scasdi/balancing-cube-main/hardware/cube.kicad_sch

## KiCad design hardware/cube.kicad_sch (2026-10-06)

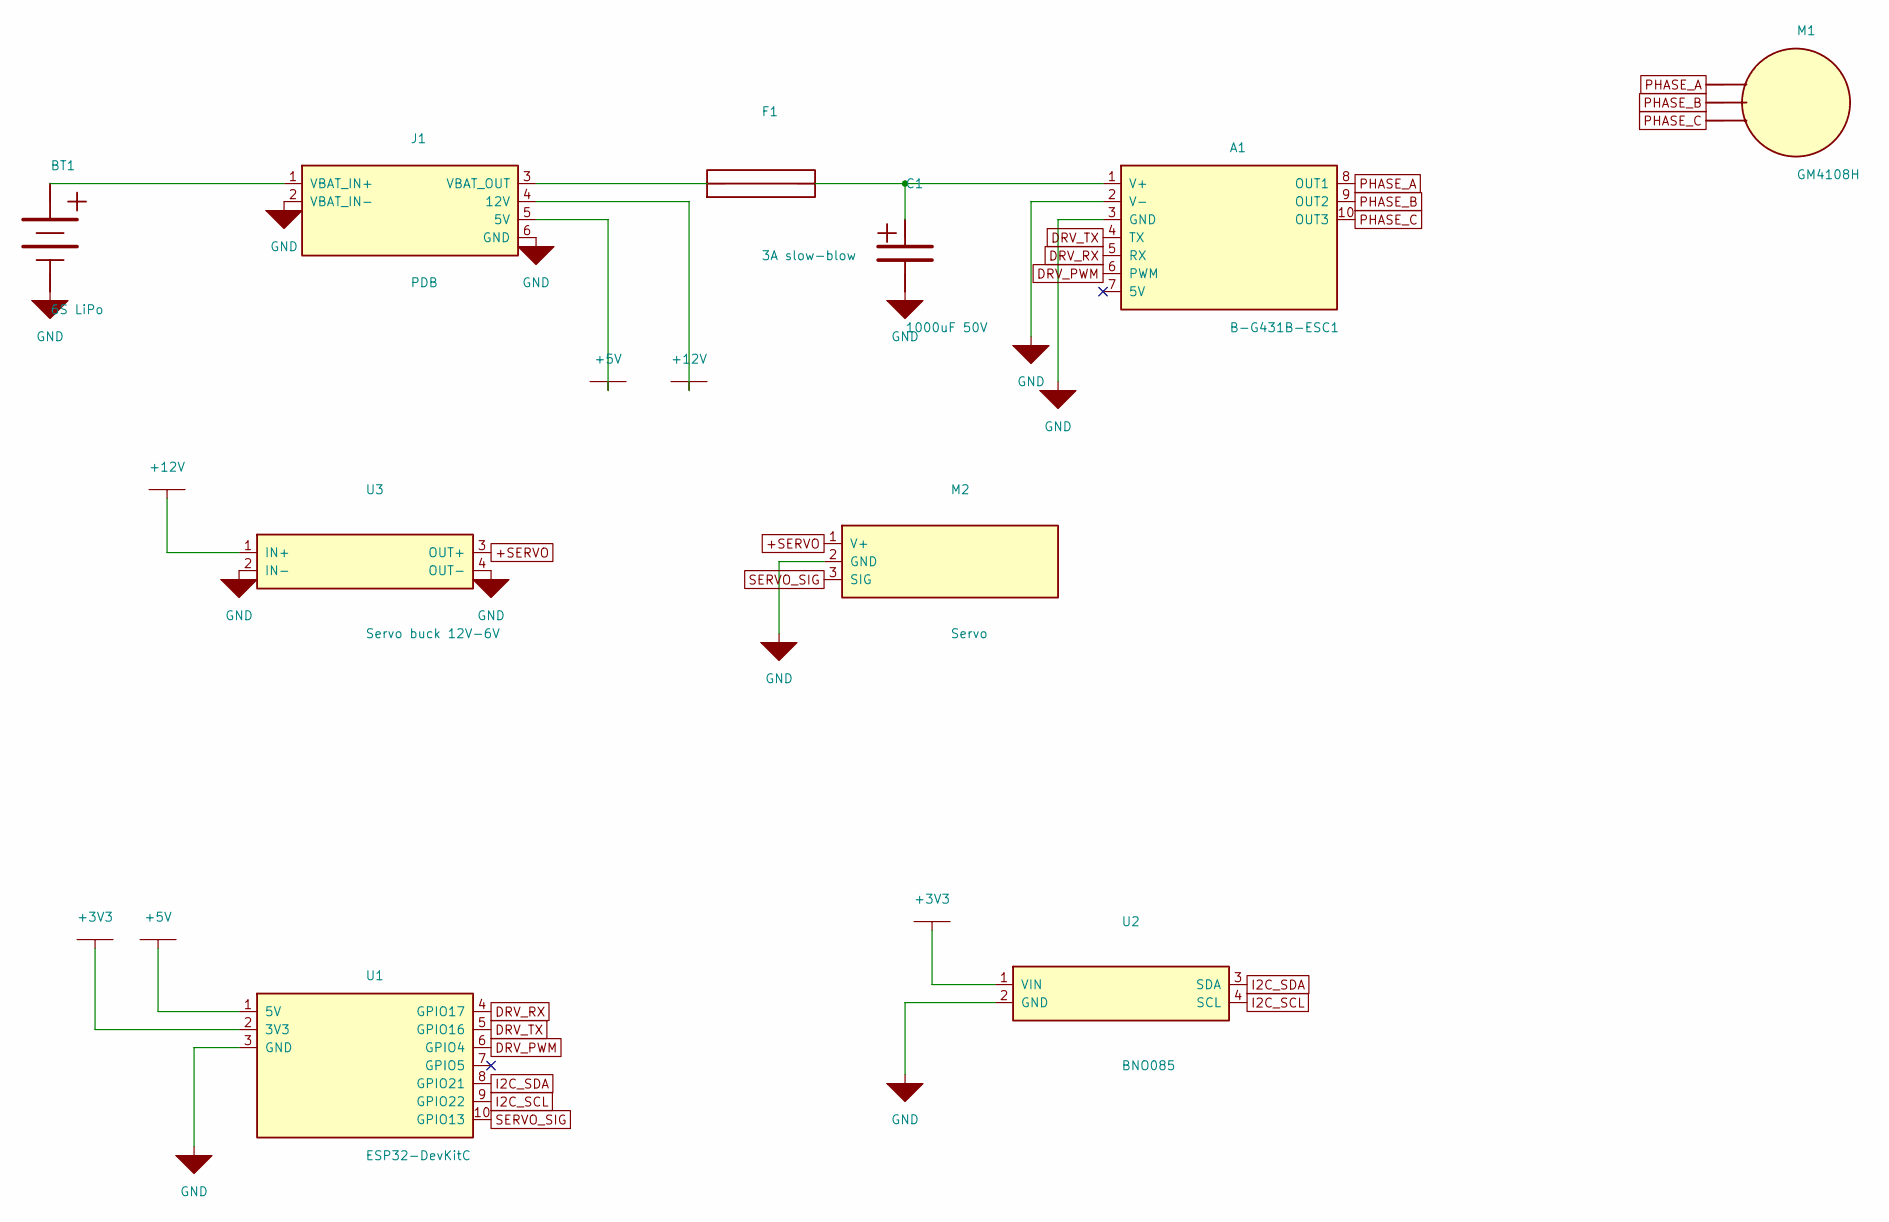
[picture p1: schematic cube.kicad_sch]

Parts:
A1: B-G431B-ESC1
BT1: 6S LiPo
C1: 1000uF 50V
F1: 3A slow-blow
J1: PDB
M1: GM4108H
M2: Servo
U1: ESP32-DevKitC
U2: BNO085
U3: Servo buck 12V-6V

Connections:
+3V3: U1.2 (3V3), U2.1 (VIN)
+5V: J1.5 (5V), U1.1 (5V)
+12V: J1.4 (12V), U3.1 (IN+)
+SERVO: M2.1 (V+), U3.3 (OUT+)
DRV_PWM: A1.6 (PWM), U1.6 (GPIO4)
DRV_RX: A1.5 (RX), U1.4 (GPIO17)
DRV_TX: A1.4 (TX), U1.5 (GPIO16)
GND: A1.2 (V-), A1.3 (GND), BT1.2, C1.2, J1.2 (VBAT_IN-), J1.6 (GND), M2.2 (GND), U1.3 (GND), U2.2 (GND), U3.2 (IN-), U3.4 (OUT-)
I2C_SCL: U1.9 (GPIO22), U2.4 (SCL)
I2C_SDA: U1.8 (GPIO21), U2.3 (SDA)
unnamed: A1.1 (V+), C1.1, F1.2
unnamed: BT1.1, J1.1 (VBAT_IN+)
unnamed: F1.1, J1.3 (VBAT_OUT)
PHASE_A: A1.8 (OUT1), M1.1
PHASE_B: A1.9 (OUT2), M1.2
PHASE_C: A1.10 (OUT3), M1.3
SERVO_SIG: M2.3 (SIG), U1.10 (GPIO13)
