scasdi/balancing-cube-main/src/ESP/commands.cpp

#include "ESP/commands.h"
#include "ESP/comms.h"
#include "ESP/get_params.h"
#include "ESP/state_machine.h"
#include "ESP/LQR.h"
#include "ESP/storage.h"
#include "ESP/pins.h"
#include "components/servo.h"
#include "components/motor_driver.h"
#include <Arduino.h>

static int last_button_state = LOW;
static unsigned long last_debounce_time = 0;
static const unsigned long DEBOUNCE_DELAY_MS = 50;

String process_command(String command) {
    command.trim();

    if (command.startsWith("SET_GAINS:")) {
        String gains_str = command.substring(10);
        int first_comma = gains_str.indexOf(',');
        int second_comma = gains_str.indexOf(',', first_comma + 1);
        
        if (first_comma != -1 && second_comma != -1) {
            float k1 = gains_str.substring(0, first_comma).toFloat();
            float k2 = gains_str.substring(first_comma + 1, second_comma).toFloat();
            float k3 = gains_str.substring(second_comma + 1).toFloat();
            
            lqr_set_gains(k1, k2, k3);
            storage_save_gains(k1, k2, k3);
            return "GAINS_SYNC_OK";
        }
        return "ERROR: INVALID_GAIN_FORMAT";
    }
    else if (command.startsWith("10 ")) {
        float speed_percent = command.substring(3).toFloat();
        command_motor_pwm_speed(speed_percent);
        char buf[32];
        snprintf(buf, sizeof(buf), "SPEED_SET: %.1f%%", speed_percent);
        return String(buf);
    }
    else if (command == "BALANCE") {
        request_state(State::Balance);
        return "BALANCE_MODE_ACTIVATED";
    }
    else if (command == "STOP") {
        request_state(State::Spindown);
        return "SPINNING_DOWN";
    }
    else if (command == "CLEAR_FAULT") {
        request_clear_fault();
        return "FAULT_CLEARED";
    }
    else if (command == "STATUS") {
        // WORST is the longest control cycle since the last reset, and IN names
        // the state it ran in. At or above the 20000 us period means the loop
        // is not keeping its deadline.
        char buf[112];
        snprintf(buf, sizeof(buf), "STATE: %s  FAULT: %s  WORST: %luus IN %s",
                 state_name(get_state()), fault_name(get_fault()),
                 (unsigned long)get_worst_cycle_us(),
                 state_name(get_worst_cycle_state()));
        return String(buf);
    }
    else if (command == "RESET_WORST") {
        request_reset_worst();
        return "WORST_RESET";
    }
    else if (command == "CALIBRATE_ZERO") {
        request_state(State::Calibrate);
        return "STARTING_CALIBRATION";
    }
    else if (command == "GET_PITCH") {
        float pitch_deg = get_shared_pitch_rad() * 180.0f / PI;
        char buf[32];
        snprintf(buf, sizeof(buf), "CURRENT_PITCH: %.2f", pitch_deg);
        return String(buf);
    }

    return "UNKNOWN_CMD: " + command;
}

void commands_init() {
    pinMode(BUTTON, INPUT);
    last_button_state = digitalRead(BUTTON);
}

void commands_update(unsigned long currentMillis) {
    int current_button_state = digitalRead(BUTTON);

    if (current_button_state != last_button_state) {
        last_debounce_time = currentMillis;
    }

    if ((currentMillis - last_debounce_time) > DEBOUNCE_DELAY_MS) {
        static int button_validated_state = LOW;

        if (current_button_state != button_validated_state) {
            button_validated_state = current_button_state;

            if (button_validated_state == HIGH) {
                send_comm_message("BUTTON_PRESSED");
                servo_jump(); 
            }
        }
    }
    last_button_state = current_button_state;

    check_bluetooth_commands();

    if (Serial.available()) {
        String incoming_cmd = Serial.readStringUntil('\n');
        incoming_cmd.trim();
        if (incoming_cmd.length() > 0) {
            if (incoming_cmd == "START_PENDULUM") {
                request_state(State::SysId);
                get_params_start(10000);
            } 
            else if (incoming_cmd == "START_MOTOR_TEST") {
                request_state(State::SysId);
                get_params_start(5000);
            }
            else {
                String reply = process_command(incoming_cmd);
                send_comm_message(reply.c_str());
            }
        }
    }
}
