scasdi/balancing-cube-main/(commit log)

2026-05-23 adding IMU sensor files
2026-05-24 adding imu sensor code, wifi and web server code
2026-05-29 adding commands support and expanding wifi support with button
2026-06-10 adding files for ESP-to-driver and driver-to-motor communication
2026-06-15 servo working
2026-06-21 finalizing param_get flow
2026-06-29 first successful servo jump with extarnel power supply.
2026-07-10 adding driver_ESP comms and bluetooth support
2026-07-15 new versions for driver_motor
2026-07-15 esp to driver update
2026-09-18 Add state machine contract headers (interfaces only, no implementation)
    Proposed interface for the control-side state machine, pending review:
    - states.h State, Event and FaultCode enums. Adds Spindown and a
    latched Fault carrying a reason code, so a trip is
    debuggable after the fact.
    - types.h ControlInput, ControlOutput and Limits. All thresholds
    gathered in one struct; SI units throughout.
    - state_machine.h state_step() as a pure function - no globals, no hardware,
    no clock reads - so the transition table can be exercised
    by host-side unit tests without an ESP32.
    No implementation an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
2026-09-18 Scoped State enum; add Init, Spindown and latched Fault
    State machine naming and structure. No change to the control law or to the
    20 ms loop rate.
    - cube_state -> enum class State : uint8_t. Values were global identifiers;
    IDLE in particular collides readily with Arduino and ESP-IDF macros, and a
    plain enum blocks adding FaultCode, which needs its own None.
    - EDGE_BALANCE -> Balance. The 3D cube balances on a corner; the old name
    baked the 2D prototype into the interface.
    - FALL_TO_IDLE -> Spindown. The old name described a transition, not a state,
    and promised an exit the code never performed.
    - Adds Init, and Fault carrying a FaultCode so a trip is debuggable.
    - init_controller()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
    [commands.cpp, comms.cpp, main.cpp, state_machine.cpp]
2026-10-05 Move STM32 driver sources out of the ESP32 build
    The project could not compile. PlatformIO builds everything under src/, and
    five files each defined setup() and loop():
    src/main.cpp
    src/components/ESP_driver.cpp
    src/components/ESP_to_driver.cpp
    src/components/driver_to_motor_const.cpp
    src/components/driver_to_motor_dyn.cpp
    The last four are firmware for the B-G431B motor driver, not the ESP32. Two
    also use STM32 pin names (PA8, PC10) that do not exist on this target.
    Moved verbatim to firmware/driver/ - contents unchanged, so building them for
    the G431 later works exactly as before. Adds a README there explaining why
    they sit outside src/.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
2026-10-05 Fix comms.cpp build: include the headers it calls into
    comms.cpp calls set_state() and get_params_start() but included neither
    ESP/state_machine.h nor ESP/get_params.h, so both were undeclared at the
    call site. Pre-existing, but surfaced now that the project builds far
    enough to reach this translation unit.
    Audited every file under src/ for the same fault: each project symbol a
    file references is now reachable through that file's include graph, and
    every function declared in include/ has exactly one definition.
    Claude-Session: https://claude.ai/code/session_016JpVBg7jcYmKKG1BBj9Xst
    [comms.cpp]
2026-10-05 Drop SimpleFOC from lib_deps and remove the STM32 driver sources
    No file under src/ or include/ includes SimpleFOC: verified by grep for
    SimpleFOC, BLDCMotor and BLDCDriver, and by listing every <...> include in
    the firmware. SimpleFOC belongs to the motor driver, a separate program on
    the STM32.
    PlatformIO compiles every declared lib_dep whether or not a source includes
    it, so SimpleFOC 2.4.0 was being built against arduino-esp32 3.20017
    (ESP-IDF 4.x) and failing on driver/mcpwm_prelude.h and on an
    ESP32CurrentSenseParams initializer. The library requires ESP-IDF 5.x. The
    ESP32 firmware never called any of it.
    Also removed firmware/driver/, which is unreferenced by this build. Those
    files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
2026-10-05 Use huge_app partition table: firmware exceeds the default 1.25 MB slot
    The image links to 1,582,753 bytes against the default table's 1,310,720 byte
    app partition. The size comes from carrying Bluetooth Classic, WiFi and the
    async web server in one binary; nothing here is unexpected or removable
    without dropping a transport the project uses.
    huge_app.csv gives a 3 MB app partition by keeping only one OTA slot. This
    firmware is flashed over USB, so the second slot was never used. It also
    leaves roughly 1.4 MB of headroom for the LQR, telemetry and driver protocol
    still to come, where min_spiffs.csv would have left under 300 kB.
    No filesystem is mounted - the dashboard page is a string lite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
2026-10-05 Keep the control task bounded: defer comms and flash, single-writer state
    The control task runs at a fixed 20 ms period on core 1. The discrete LQR it
    serves was derived for a constant Ts, so the task needs a worst-case execution
    time that can be computed from facts the task controls. Six calls broke that.
    1. send_comm_message(), reached from set_state() and latch_fault() on every
    transition, called into LwIP (taking the TCP/IP core lock held by the WiFi
    task on core 0), Bluedroid SPP (which has peer flow control), and a blocking
    UART0 write. A priority-3 task on core 1 waiting on a lock owned by another
    task on core 0 has no bound it can compute.
    2. storage_save_pitch_offset()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
    [commands.cpp, comms.cpp, imu_sensor.cpp, main.cpp, motor_driver.cpp, state_machine.cpp]
2026-10-05 Record which state the worst cycle ran in; correct the core-assignment comments
    WORST came back at 15803 us against a 20000 us period, so the number needs a
    second dimension to be actionable: a slow cycle in Calibrate and a slow cycle
    in Balance have different causes and different consequences. check_cycle_time()
    now records the state alongside the time, STATUS reports it as "WORST: N IN
    <state>", and RESET_WORST restarts the measurement so a specific window can be
    timed without a reboot. The reset goes through the request queue like every
    other transition, so the control task stays the only writer.
    Also corrected comments that claimed loop() runs on core 0. It does not:
    arduino-esp32 pins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
    [commands.cpp, main.cpp, state_machine.cpp]
2026-10-05 Add KiCad schematic for the 2D prototype, with its generator
    hardware/gen_schematic.py emits hardware/cube.kicad_sch. Generated rather than
    drawn so the sheet stays consistent with include/ESP/pins.h: edit the PARTS and
    NETS tables, re-run, and the schematic follows.
    Connectivity is expressed with a global label on every pin instead of routed
    wires - electrically identical, since KiCad joins nets by label name, and it
    keeps the generator free of routing geometry.
    Driver pinout taken from UM2516 Figures 6 and 7: the B-G431B-ESC1 input header
    is V- / 5V / TX / RX / PWM / GND / V+, with V- and GND as separate pads. V-
    takes the motor return, GND is the signal reference for TX/RX. The two
    micr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
    [cube.kicad_sch]
2026-10-05 Find the cube's COM port by Bluetooth address instead of by keyword
    find_esp32_port() matched any port whose description or hwid contained one of
    usb / uart / ch340 / cp210 / bluetooth / bthenum, and returned the first hit.
    On a machine with eight paired SPP ports every one of them matches: Windows
    gives them all the same description, "Standard Serial over Bluetooth link".
    It picked COM3, an outgoing port bound to an unrelated device that was powered
    off, and opening it failed with ERROR_SEM_TIMEOUT - which reads as a broken
    Bluetooth stack rather than the wrong port.
    The device's identity is its BD_ADDR, and Windows embeds it in the hwid of its
    outgoing port, so match on that. The name is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
    [terminal.py]
2026-10-06 Redraw the schematic: real glyphs, drawn power chain, debug parts removed
    The first sheet was a correct netlist and a poor drawing. Every part was a
    rectangle and every connection was a matching pair of text labels, so the
    topology could not be read - you could not see that C1 sits across the driver's
    terminals, only infer it from two labels that happened to agree.
    Changes:
    - Passives carry their real symbols. BT1 is alternating cell plates, C1 is a
    polarised capacitor with its plates and + marker, F1 is the fuse glyph, M1 is
    a circle. The modules stay rectangles, which is correct: the PDB, driver,
    buck, IMU and ESP32 are finished boards you wire to, so a connector is the
    honest re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
    [cube.kicad_sch]
2026-10-06 Drop the ground bus, tidy the rails, fix the power symbol text
    Three fixes, all from reading the rendered sheet.
    The drawn ground bus is gone. A schematic's GND is one node with zero impedance
    between its pins - it has no topology - so drawing it as a line implied a
    physical arrangement the sheet cannot express, which is misleading rather than
    merely untidy. The real topology lives in the harness drawing. Ground pins now
    carry a GND symbol directly, with a short dog-leg only where two symbols would
    otherwise overlap. That removed 21 wires.
    The power symbol's Value sat level with its own glyph, so "GND" printed over
    the triangle and could not be moved from the instance, because the position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
    [cube.kicad_sch]
2026-10-06 Snap the sheet to KiCad's grid, so it can be edited by hand
    Parts sat at coordinates like 73.81 and 66.19, which are not multiples of the
    1.27 mm schematic grid. The wire tool snaps to that grid, so the cursor could
    not land on a pin: drawing a wire between two pins was impossible, not merely
    awkward. That made the sheet read-only in practice, which defeats the point of
    generating it.
    Pin offsets inside a symbol are already multiples of 1.27, so snapping the
    placement is enough to put every pin on the grid. snap() is applied in abs_pin()
    and to each route corner rather than to the tables, so the coordinates stay
    readable and nothing can drift off-grid later.
    Verified: all 79 sheet-level co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
    [cube.kicad_sch]
2026-10-06 Add the driver bring-up test: open-loop spin on the B-G431B-ESC1
    A separate PlatformIO project under driver/, for a different chip and toolchain
    than the cube's ESP32 firmware. Open that folder in VS Code rather than the
    repository root: PlatformIO binds to the platformio.ini where it is opened, and
    the root one is the ESP32's. .pio is already covered by the existing gitignore.
    The sketch does one thing - turn the motor slowly in open loop - to prove the
    board can be flashed and the motor is wired correctly. No sensor, no FOC, no
    current control, and deliberately no initFOC() or loopFOC(), whose presence
    without a sensor is the usual reason this board sits still.
    The voltage limit is deriv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
    [main.cpp]
2026-10-06 driver: take SimpleFOC from git, for Arduino STM32 Core 3 compatibility
    The build failed in SimpleFOC's stm32_mcu.cpp:
    error: cannot convert 'TIM_HandleTypeDef*' to 'TIM_TypeDef*'
    enableTimerClock(handle);
    Arduino STM32 Core 3 changed that function's signature, and the SimpleFOC
    release on the PlatformIO registry still passes the handle. The platform
    installs Core 3, so the two cannot be built together.
    Upstream fixed it in PR #550, merged to master but not in a release at the time
    of writing, so lib_deps points at the git repository. That makes the dependency
    a moving target, which the comment says plainly - it should go back to a pinned
    registry version once one carries the fix.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
2026-10-06 driver: patch SimpleFOC at build time instead of chasing versions
    SimpleFOC will not compile against the Arduino STM32 core this platform ships.
    The core changed enableTimerClock() to take a TIM_TypeDef*, SimpleFOC still
    passes a TIM_HandleTypeDef*, and neither the registry release nor git master has
    caught up - switching to master changed nothing, which was my mistake to assume
    without checking.
    Rather than pin a framework version by guesswork, a pre-build script rewrites the
    one broken call: TIM_HandleTypeDef carries the TIM_TypeDef* the function now
    wants in its Instance member, so enableTimerClock(handle) becomes
    enableTimerClock(handle->Instance).
    Running it as a build step rather tha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
    [patch_simplefoc.py]
2026-10-06 driver: raise the open-loop current to 0.5 A, past breakaway
    At 0.2 A the motor did not move and the bus current was indistinguishable from
    the board's idle draw. That is consistent with the field rotating while the rotor
    stays put: the torque at 0.2 A is below breakaway for this motor, cogging plus
    static friction.
    Torque is proportional to current, so the fix is the current, not the code. 0.5 A
    through the 5 ohm phase needs 2.5 V, which the existing expression derives.
    The comment now says 0.8 A is the next and last step before stopping: a GM4108H
    is rated around 1 A continuous, and past that the test is heating the winding
    rather than proving anything.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
    [main.cpp]
2026-10-06 driver: fix the stale voltage comment left by the current change
    The trailing comment still read 1.0 V after TARGET_CURRENT_A went to 0.5 A. The
    expression is derived, so the number was only ever a reader's aid - but a comment
    that disagrees with its own line is worse than none.
    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
    [main.cpp]
2026-10-06 driver: repeat the status every 2 s instead of printing once at boot
    Printing only in setup() meant catching a single message in the two seconds
    after reset, which needs the serial monitor open at exactly the right moment -
    awkward on a board whose reset button is not obvious, and the reason the test
    could not be run at all.
    The status now repeats every two seconds from loop(), so the monitor can be
    opened whenever and still show what the board is doing. The failure path says so
    explicitly rather than going quiet: a driver that did not initialise now reports
    itself on every cycle instead of leaving a silent board that looks identical to a
    wiring fault.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
    [main.cpp]
2026-10-06 driver: turn on SimpleFOC's debug output to find why init fails
    driver.init() returns 0 and nothing else, so "FATAL: driver init failed" tells us
    the output stage is never configured but not what went wrong. Everything observed
    so far - no movement at any current, bus current unchanged with the motor
    attached - follows from that one failure.
    SimpleFOCDebug::enable(&Serial) makes the library print the actual reason during
    init, typically which timer or pin it could not configure on this board. Asking
    the library beats guessing at it from the outside.
    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
    [main.cpp]
2026-10-06 driver: add the HAL timer module flag the 6-PWM setup needs
    driver.init() was failing with no message. The SimpleFOC community documents
    build flags for this board that I found earlier and did not act on, and one of
    them explains it: HAL_TIM_MODULE_ENABLED. Without the timer HAL module compiled
    in there is nothing for _configure6PWM to configure, so init returns 0 silently -
    which matches exactly what the board reported.
    HAL_OPAMP_MODULE_ENABLED comes from the same source; this board routes its
    current sensing through the G431's internal op-amps.
    SIMPLEFOC_STM32_DEBUG is added so that if init still fails, the library says
    which pin or timer it could not use instead of returning a bare zero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
2026-10-06 Revert the build flags and SimpleFOCDebug: both were wrong
    HAL_TIM_MODULE_ENABLED was not the problem. The build log says so directly -
    "warning: HAL_TIM_MODULE_ENABLED redefined" - because the core already defines
    it. The flag was redundant and my reasoning about why init() failed was wrong.
    SimpleFOCDebug::enable() made things actively worse. It sits before the first
    Serial.println in setup(), and after adding it the board prints nothing at all
    rather than the FATAL line it printed before, so it hangs there. Whatever it
    does on this target, it does not survive.
    Back to the state that at least reported its own failure. driver.init() still
    returns 0 and we still do not know why, but a boar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
    [main.cpp]
2026-10-06 driver: link SimpleFOC without archiving so the STM32 PWM backend binds
    driver.init() returned 0 on every attempt and the bus current was identical
    with and without the motor attached, because no PWM was ever generated.
    SimpleFOC selects its PWM backend with weak symbols. generic_mcu.cpp defines
    a weak _configure6PWM() returning SIMPLEFOC_DRIVER_INIT_FAILED; stm32_mcu.cpp
    defines the strong override that programs TIM1. PlatformIO builds a library
    into a static archive by default, and a linker extracts an archive member only
    to satisfy an unresolved symbol - the weak stub satisfies the call immediately,
    so the STM32 member is never extracted and its strong symbol never overrides.
    BLDCDriver6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
2026-10-06 driver: make the bring-up test diagnose the serial link separately
    The test could not distinguish a dead serial link from a dead power stage:
    both looked like an empty monitor. Three states are now separable.
    - A banner is printed after a 2.5 s delay, so `pio run -t upload -t monitor`
    has attached before the first evidence is emitted. No banner means the link
    to the PC is broken, not that the motor failed.
    - "calling driver.init() ..." is printed before the call, so a hang inside the
    library leaves the banner with no result line after it, rather than looking
    identical to a link failure.
    - A 500 ms heartbeat carries a climbing counter, millis() and the init result,
    which separates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
    [main.cpp]
2026-10-06 driver: crawl the field at 0.05 rad/s so a multimeter can see it
    The phase-voltage measurement this is meant to support could not have worked.
    Open loop spins the field at commanded velocity x pole pairs, so 2 rad/s
    mechanical is 22 rad/s electrical - about 3.5 Hz. A DMM averages over its
    sampling window and would have reported the modulation centre as one steady
    number, indistinguishable from a dead power stage.
    At 0.05 rad/s the electrical period is ~11 s and each phase sweeps its range
    slowly enough to read off the display. Raise it back to 2.0 before timing a
    rotor, since a mechanical revolution now takes over two minutes.
    Also drops a claim about breakaway torque that the init() fix i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
    [main.cpp]
2026-10-06 driver: drive fixed duty via setPwm() to isolate the timer from the motion layer
    driver.init() returns 1, enable() sets PHASE_ON and setPwm() clamps correctly,
    yet all three phase pads read 0 V and the bus draws 0.069 A - the same quiescent
    figure measured before any firmware was ever uploaded. The power stage has never
    switched, so the motion layer is no longer worth reading.
    loop() now calls driver.setPwm() with three fixed, distinct voltages instead of
    motor.move(). That removes velocityOpenloop(), the electrical angle, the sine
    tables and the sensor-direction defaults from the measurement, leaving the last
    software step before the timer registers.
    setPwm() clamps each argument to volta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
    [main.cpp]
2026-10-06 driver: energise one phase at a time to localise the shoot-through
    Driving all three phases proved the timer and power stage work - two pads held
    their commanded 2.5 V and 1.2 V - but the bus drew ~1 A with no motor attached,
    so current circulates inside the board. All three body diodes still measure
    0.494 V against a 0.497 V baseline, so no FET was damaged.
    loop() now sweeps A, B, C, all-off at 8 s per step and prints each transition so
    an ammeter reading can be attributed to the phase that caused it. The all-off
    step is the baseline and should show the 0.069 A quiescent draw.
    current on any single phase -> dead-time configuration, most likely a
    fall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
    [main.cpp]
2026-10-06 driver: select the test phase at compile time, not with a timed sweep
    The sweep required serial and the bus powered simultaneously so an ammeter
    reading could be attributed to the phase that caused it. That combination is
    ruled out until a USB isolator is available, so the selection moves to build
    time: TEST_PHASE picks one phase, the boot banner states which, and the whole
    measurement happens with USB unplugged.
    This is stricter than the sweep rather than a fallback - there is no timing to
    line up and no transition to misread. Confirm the banner over USB with the
    supply off, unplug, power the bus, read the current. Four builds: A, B, C, and
    none as the baseline.
    static_assert catches an o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
2026-10-06 driver: print the library's real dead-time settings at boot
    The shoot-through hypothesis rests on the dead-time configuration, which has so
    far been assumed rather than read. SimpleFOC computes
    dead_time_ns = (1e9 / pwm_frequency) * dead_zone and programs it into TIM1's
    BDTR register, so printing pwm_frequency and dead_zone gives the actual
    enforced both-off time in nanoseconds.
    Also prints the duty floor, dead_zone * bus voltage, below which a commanded
    voltage produces no high-side conduction at all. That is the trap that made an
    earlier 0.3 V test phase read as a dead bridge, and having it on screen stops it
    recurring at any bus voltage.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
